COAST-Lab/Low-Cost-Multiparameter-Water-Quality-Sensor/Data Analysis Scripts/README.md

# Data Analysis Scripts

This folder contains data analysis scripts for the low-cost multiparameter sensor. 
The .csv file obtained from the low-cost multiparameter sensor code should be used for these scripts
NOT the .csv files obtained from the code for measurements of chlorophyll a and turbidity separately from one another. 

The 'turbidity' folder contains the Python code to analyze the turbidity measurements. and the 'chlorophyll' folder the Python code to analyze the chlorophyll a measurement
