COAST-Lab/Low-Cost-Multiparameter-Water-Quality-Sensor/Turbidity/Data Analysis Scripts/README.md

# Chlorophyll Data Analysis Scripts

This folder contains data analysis scripts for the turbidity portion of the low-cost multiparameter sensor. 
The .csv file obtained from the turbidity code should be used for these scripts
NOT the .csv files obtained from the code for measurements of chlorophyll a and turbidiy measured together.
