COAST-Lab/Low-Cost-Multiparameter-Water-Quality-Sensor/Chlorophyll/Data Analysis Scripts/README.md

# Chlorophyll Data Analysis Scripts

This folder contains data analysis scripts for the chlorophyll a portion of the low-cost multiparameter sensor. 
The .csv file obtained from the chlorophyll a code should be used for these scripts
NOT the .csv files obtained from the code for measurements of chlorophyll a and turbidiy measured together.
