COAST-Lab/Low-Cost-Multiparameter-Water-Quality-Sensor/Chlorophyll/Data Analysis/AS7341 Dilution Tests/Through Hole Design with 2:1 Ratio/2_22_24_700ms_128x_through_hole_dilutions_alan_optics_2.csv

Date and Time | ASTEP | ATIME | GAIN | LED Status | LED Intensity | Test | Seconds | Milliseconds | Type | F1 (Basic) | F2 (Basic) | F3 (Basic) | F4 (Basic) | F5 (Basic) | F6 (Basic) | F7 (Basic) | F8 (Basic) | Clear (Basic) | NIR (Basic) | Type | F1 (Raw) | F2 (Raw) | F3 (Raw) | F4 (Raw) | F5 (Raw) | F6 (Raw) | F7 (Raw) | F8 (Raw) | Clear (Raw) | NIR (Raw)
2112/5/32 (Thursday) 30:46:22 | 999 | 255 | 8 | LED ON | 255 | 0.0 | 3 | 3352 | BASIC COUNTS | 0.00 | 0.00 | 0.00 | 0.00 | 0.00 | 0.00 | 0.00 | 0.00 | 0.00 | 0.00 | RAW VALUES | 0 | 0 | 0 | 0 | 0 | 0 | 0 | 0 | 0 | 0
2112/5/32 (Thursday) 30:46:25 | 999 | 255 | 8 | LED ON | 255 | 0.0 | 6 | 6380 | BASIC COUNTS | 0.00 | 0.01 | 0.00 | 0.00 | 0.00 | 0.00 | 0.00 | 0.00 | 0.01 | 0.00 | RAW VALUES | 434 | 701 | 63 | 31 | 22 | 26 | 30 | 21 | 670 | 0
2112/5/32 (Thursday) 30:46:28 | 999 | 255 | 8 | LED ON | 255 | 0.0 | 9 | 9403 | BASIC COUNTS | 0.00 | 0.01 | 0.00 | 0.00 | 0.00 | 0.00 | 0.00 | 0.00 | 0.01 | 0.00 | RAW VALUES | 432 | 702 | 63 | 31 | 22 | 26 | 31 | 21 | 671 | 0
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
