COAST-Lab/Low-Cost-Multiparameter-Water-Quality-Sensor/Chlorophyll/Data Analysis/AS7341 Dilution Tests/Through Hole Design with 2:1 Ratio/LED with marine grade epoxy/2_29_24_graph_128x_700ms_LOD.png

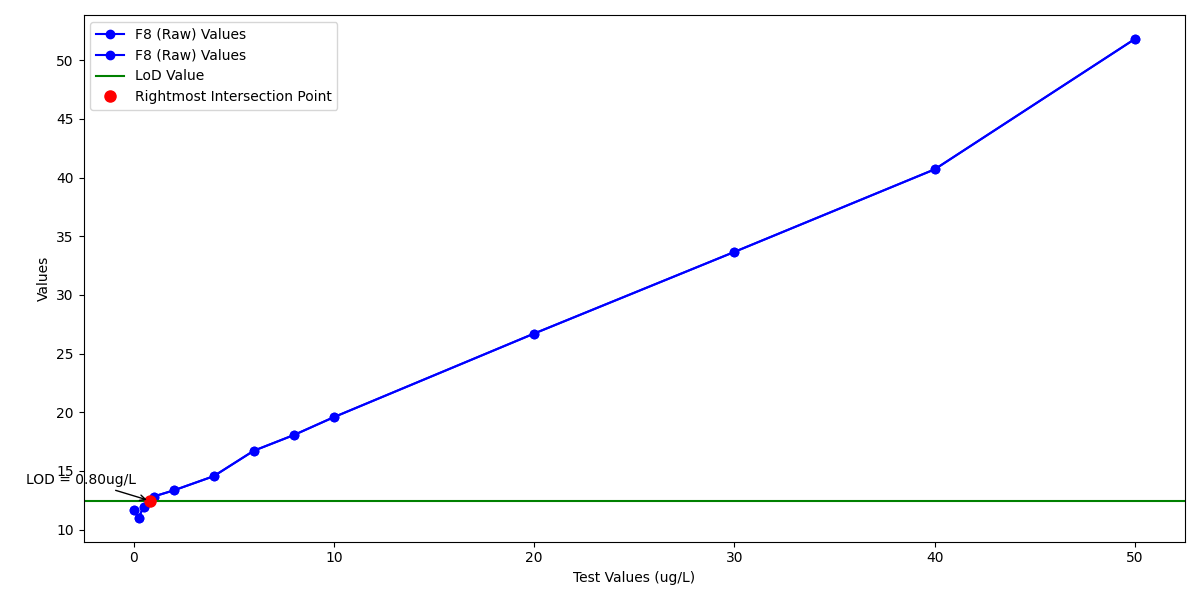
Chlorophyll/Data Analysis/AS7341 Dilution Tests/Through Hole Design with 2:1 Ratio/LED with marine grade epoxy/2_29_24_graph_128x_700ms_LOD.png
