COAST-Lab/Low-Cost-Multiparameter-Water-Quality-Sensor/Chlorophyll/Data Analysis/AS7341 Dilution Tests/Through Hole Design with 2:1 Ratio/LED with marine grade epoxy/2_29_24_LoD_128x_700ms.png

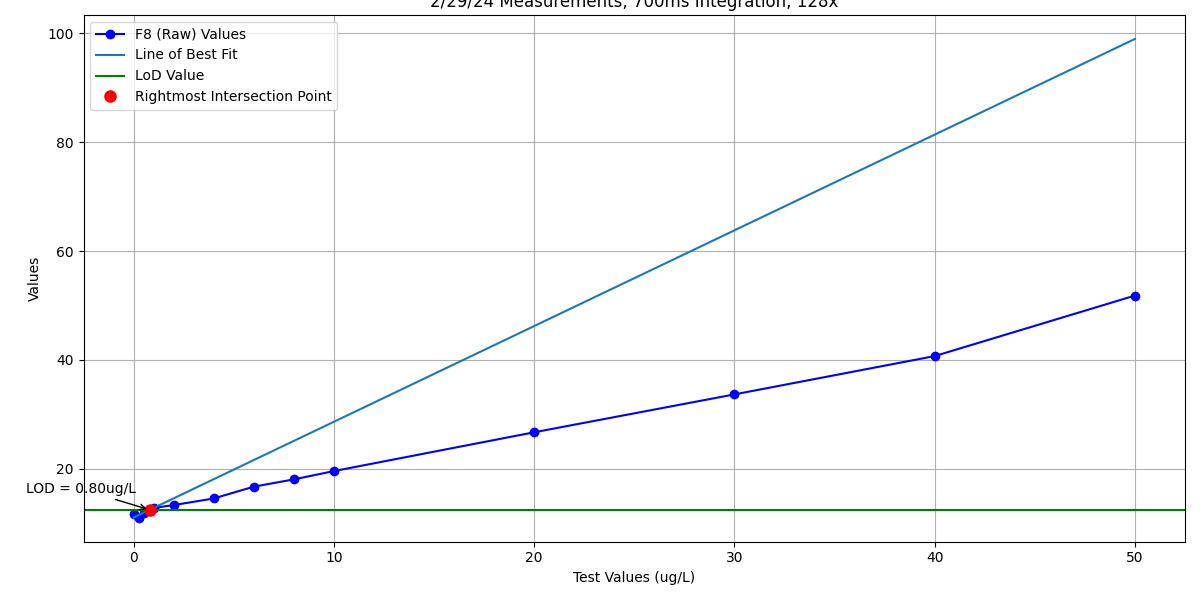
Chlorophyll/Data Analysis/AS7341 Dilution Tests/Through Hole Design with 2:1 Ratio/LED with marine grade epoxy/2_29_24_LoD_128x_700ms.png
