COAST-Lab/Low-Cost-Multiparameter-Water-Quality-Sensor/Hardware/Circuit Diagram/low_cost_sesnor.png

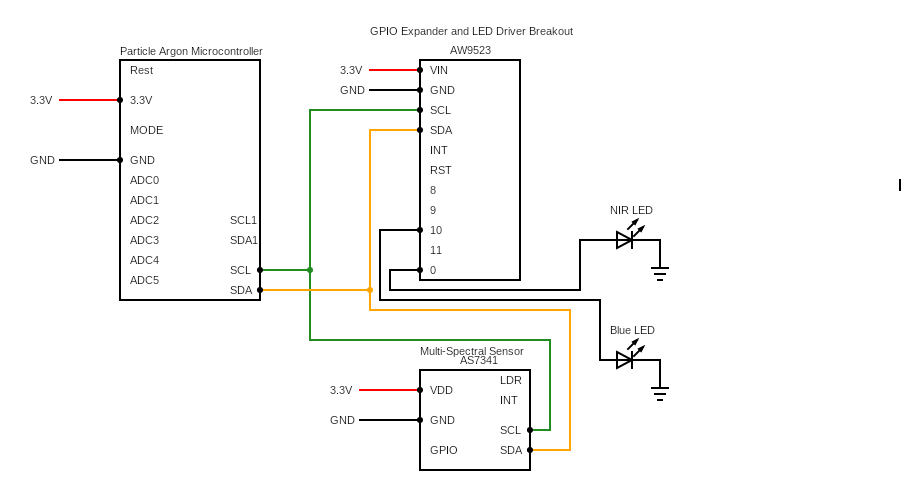
Hardware/Circuit Diagram/low_cost_sesnor.png
