COAST-Lab/Low-Cost-Multiparameter-Water-Quality-Sensor/Hardware/Water Resistant Housing/light_blocking_cap_2.stl

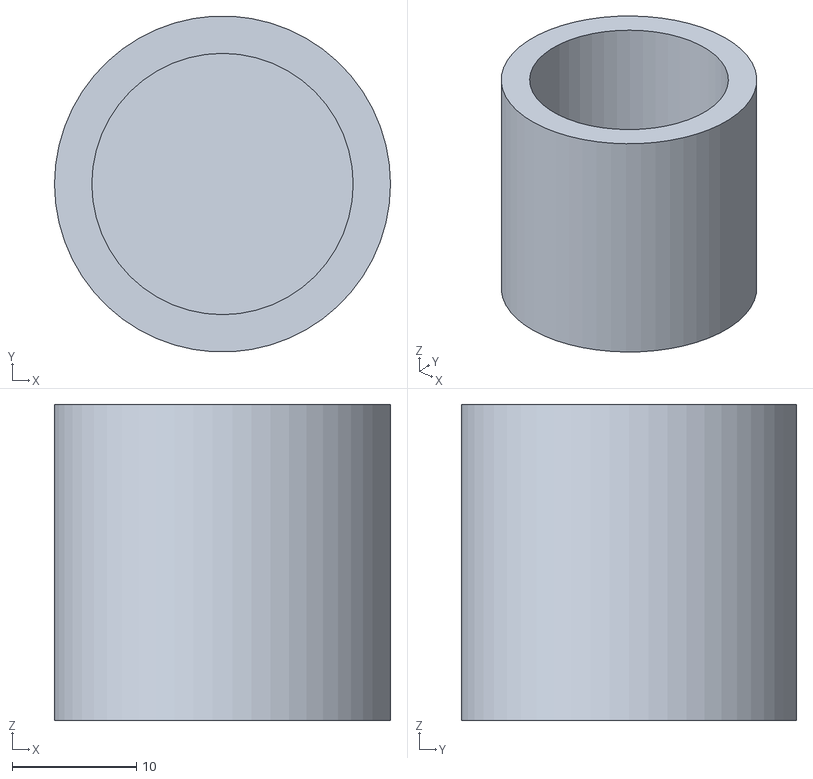
[picture p9: CAD file, 2024-05-28]
Hardware/Water Resistant Housing/light_blocking_cap_2.stl
27.0 x 27.0 x 25.4
