COAST-Lab/Low-Cost-Multiparameter-Water-Quality-Sensor/Hardware/Water Resistant Housing/3d_enclosure_2_19_top_1.stl

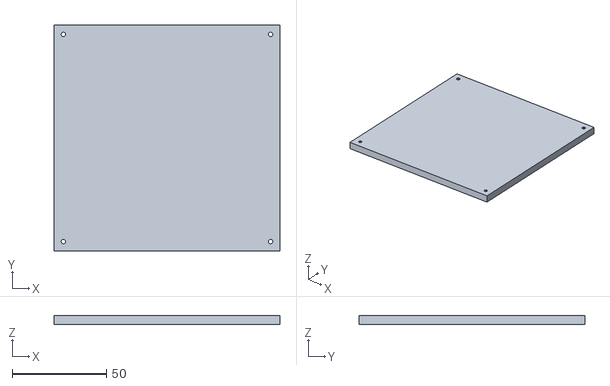
[picture p10: CAD file, 2024-05-28]
Hardware/Water Resistant Housing/3d_enclosure_2_19_top_1.stl
120.0 x 120.0 x 5.00
