COAST-Lab/Low-Cost-Multiparameter-Water-Quality-Sensor/Hardware/Water Resistant Housing/3d_enclosure_2_19_1_9_cm.stl

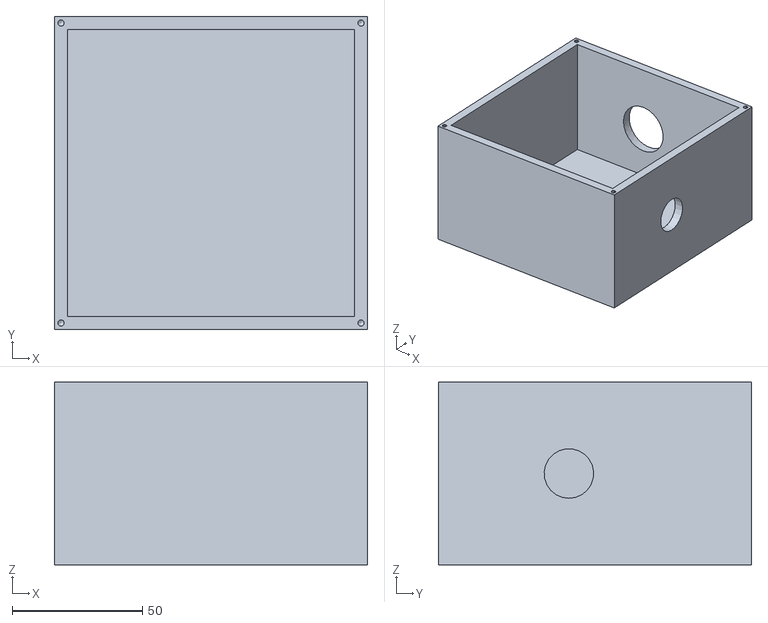
[picture p11: CAD file, 2024-05-28]
Hardware/Water Resistant Housing/3d_enclosure_2_19_1_9_cm.stl
120.0 x 120.0 x 70.0
