COAST-Lab/Low-Cost-Multiparameter-Water-Quality-Sensor/Hardware/Cuvette Holder/alan_optics_through_hole_chl_turbidity_screw_holes.stl

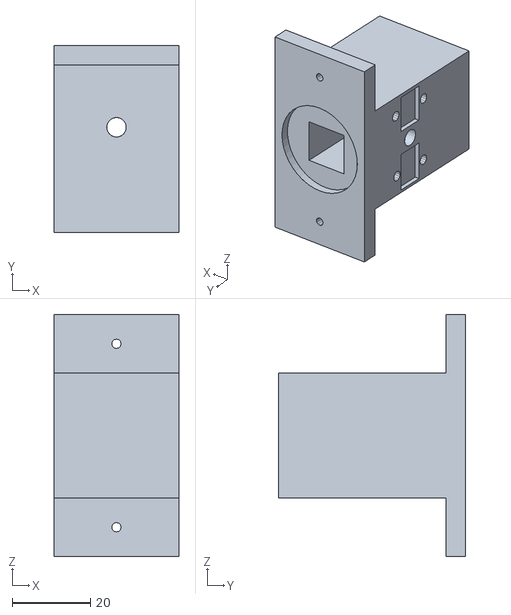
[picture p12: CAD file, 2024-05-31]
Hardware/Cuvette Holder/alan_optics_through_hole_chl_turbidity_screw_holes.stl
32.0 x 48.0 x 62.0
