COAST-Lab/Low-Cost-Multiparameter-Water-Quality-Sensor/(list of files, cad)

Other CAD files:
Hardware/Cuvette Holder/alan_optics_through_hole_chl_turbidity_screw_holes.ipt
Hardware/Water Resistant Housing/3d_enclosure_2_19_1_9_cm.ipt
Hardware/Water Resistant Housing/3d_enclosure_2_19_top_1.ipt
Hardware/Water Resistant Housing/light_blocking_cap_2.ipt
