COAST-Lab/Low-Cost-Multiparameter-Water-Quality-Sensor/Field Tests/4.15.24 Field Test/chl_dock_test_4_15_24_no_DI.csv

Date and Time | ASTEP | ATIME | GAIN | LED Status | LED Intensity | Test | Seconds | Milliseconds | Type | F1 (Basic) | F2 (Basic) | F3 (Basic) | F4 (Basic) | F5 (Basic) | F6 (Basic) | F7 (Basic) | F8 (Basic) | Clear (Basic) | NIR (Basic) | Type | F1 (Raw) | F2 (Raw) | F3 (Raw) | F4 (Raw) | F5 (Raw) | F6 (Raw) | F7 (Raw) | F8 (Raw) | Clear (Raw) | NIR (Raw) | Approx Time
2032/5/32 (Tuesday) 30:49:58 | 999 | 255 | 8 | LED ON | 255 | 2 | 3 | 3341 | BASIC COUNTS | 0.00 | 0.00 | 0.00 | 0.00 | 0.00 | 0.00 | 0.00 | 0.00 | 0.00 | 0.00 | RAW VALUES | 0 | 1 | 2 | 4 | 5 | 7 | 11 | 14 | 54 | 19 | 10:30
2032/5/32 (Tuesday) 30:50:1 | 999 | 255 | 8 | LED ON | 255 | 2 | 6 | 6371 | BASIC COUNTS | 0.01 | 0.01 | 0.00 | 0.00 | 0.00 | 0.00 | 0.00 | 0.00 | 0.02 | 0.00 | RAW VALUES | 659 | 928 | 89 | 63 | 47 | 60 | 65 | 55 | 1376 | 24 | 10:30
2032/5/32 (Tuesday) 30:50:4 | 999 | 255 | 8 | LED ON | 255 | 2 | 9 | 9399 | BASIC COUNTS | 0.01 | 0.01 | 0.00 | 0.00 | 0.00 | 0.00 | 0.00 | 0.00 | 0.02 | 0.00 | RAW VALUES | 659 | 935 | 89 | 63 | 47 | 60 | 64 | 53 | 1381 | 24 | 10:30
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
