COAST-Lab/Low-Cost-Multiparameter-Water-Quality-Sensor/Field Tests/4.15.24 Field Test/turb_dock_test_4_15_24_no_DI.csv

Date and Time | ASTEP | ATIME | GAIN | LED Status | LED Intensity | Test | Seconds | Milliseconds | Type | F1 (Basic) | F2 (Basic) | F3 (Basic) | F4 (Basic) | F5 (Basic) | F6 (Basic) | F7 (Basic) | F8 (Basic) | Clear (Basic) | NIR (Basic) | Type | F1 (Raw) | F2 (Raw) | F3 (Raw) | F4 (Raw) | F5 (Raw) | F6 (Raw) | F7 (Raw) | F8 (Raw) | Clear (Raw) | NIR (Raw) | Approx Time
2113/7/38 (Tuesday) 38:8:4 | 999 | 255 | 8 | LED ON | 255 | 1 | 3 | 3356 | BASIC COUNTS | 0.00 | 0.00 | 0.00 | 0.00 | 0.00 | 0.00 | 0.00 | 0.00 | 0.00 | 0.00 | RAW VALUES | 7 | 19 | 26 | 35 | 39 | 47 | 61 | 70 | 238 | 92 | 10:15
2113/7/38 (Tuesday) 38:8:7 | 999 | 255 | 8 | LED ON | 255 | 1 | 6 | 6385 | BASIC COUNTS | 0.00 | 0.00 | 0.00 | 0.00 | 0.00 | 0.00 | 0.00 | 0.00 | 0.01 | 0.03 | RAW VALUES | 16 | 22 | 23 | 24 | 17 | 31 | 15 | 15 | 757 | 2778 | 10:15
2113/7/38 (Tuesday) 38:8:10 | 999 | 255 | 8 | LED ON | 255 | 1 | 9 | 9415 | BASIC COUNTS | 0.00 | 0.00 | 0.00 | 0.00 | 0.00 | 0.00 | 0.00 | 0.00 | 0.01 | 0.03 | RAW VALUES | 15 | 21 | 20 | 22 | 17 | 31 | 15 | 14 | 757 | 2776 | 10:15
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
