COAST-Lab/Low-Cost-Multiparameter-Water-Quality-Sensor/Chlorophyll/Data Analysis/Dilution Tests with Water Resistant Housing/housing_chl_4_16_24.csv

Date and Time | ASTEP | ATIME | GAIN | LED Status | LED Intensity | Test | Seconds | Milliseconds | Type | F1 (Basic) | F2 (Basic) | F3 (Basic) | F4 (Basic) | F5 (Basic) | F6 (Basic) | F7 (Basic) | F8 (Basic) | Clear (Basic) | NIR (Basic) | Type | F1 (Raw) | F2 (Raw) | F3 (Raw) | F4 (Raw) | F5 (Raw) | F6 (Raw) | F7 (Raw) | F8 (Raw) | Clear (Raw) | NIR (Raw) | Approx Time
2112/5/32 (Thursday) 30:47:20 | 999 | 255 | 8 | LED ON | 255 | 50 | 3 | 3344 | BASIC COUNTS | 0.00 | 0.00 | 0.00 | 0.00 | 0.00 | 0.00 | 0.00 | 0.00 | 0.00 | 0.00 | RAW VALUES | 0 | 0 | 0 | 0 | 0 | 0 | 0 | 0 | 0 | 0 | time
2112/5/32 (Thursday) 30:47:23 | 999 | 255 | 8 | LED ON | 255 | 50 | 6 | 6373 | BASIC COUNTS | 0.00 | 0.01 | 0.00 | 0.00 | 0.00 | 0.00 | 0.00 | 0.00 | 0.01 | 0.00 | RAW VALUES | 291 | 464 | 45 | 27 | 137 | 259 | 129 | 44 | 861 | 8 | time
2112/5/32 (Thursday) 30:47:26 | 999 | 255 | 8 | LED ON | 255 | 50 | 9 | 9404 | BASIC COUNTS | 0.00 | 0.01 | 0.00 | 0.00 | 0.00 | 0.00 | 0.00 | 0.00 | 0.01 | 0.00 | RAW VALUES | 290 | 464 | 45 | 27 | 138 | 259 | 128 | 44 | 860 | 7 | time
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
