COAST-Lab/Low-Cost-Multiparameter-Water-Quality-Sensor/Field Tests/4.23.24 Field Tests/Indoor Field Test/inside_test_chl_4_23_24_no_time.csv

Date and Time | ASTEP | ATIME | GAIN | LED Status | LED Intensity | Test | Seconds | Milliseconds | Type | F1 (Basic) | F2 (Basic) | F3 (Basic) | F4 (Basic) | F5 (Basic) | F6 (Basic) | F7 (Basic) | F8 (Basic) | Clear (Basic) | NIR (Basic) | Type | F1 (Raw) | F2 (Raw) | F3 (Raw) | F4 (Raw) | F5 (Raw) | F6 (Raw) | F7 (Raw) | F8 (Raw) | Clear (Raw) | NIR (Raw) | Approx Time
2032/5/32 (Tuesday) 30:47:29 | 999 | 255 | 8 | LED ON | 255 | 1 | 3 | 3368 | BASIC COUNTS | 0.00 | 0.00 | 0.00 | 0.00 | 0.00 | 0.00 | 0.00 | 0.00 | 0.00 | 0.00 | RAW VALUES | 0 | 0 | 0 | 0 | 0 | 0 | 0 | 0 | 0 | 0 | 11:30
2032/5/32 (Tuesday) 30:47:32 | 999 | 255 | 8 | LED ON | 255 | 1 | 6 | 6398 | BASIC COUNTS | 0.01 | 0.01 | 0.00 | 0.00 | 0.00 | 0.00 | 0.00 | 0.00 | 0.02 | 0.00 | RAW VALUES | 738 | 1088 | 86 | 47 | 31 | 46 | 49 | 35 | 1429 | 0 | 11:30
2032/5/32 (Tuesday) 30:47:35 | 999 | 255 | 8 | LED ON | 255 | 1 | 9 | 9426 | BASIC COUNTS | 0.01 | 0.01 | 0.00 | 0.00 | 0.00 | 0.00 | 0.00 | 0.00 | 0.02 | 0.00 | RAW VALUES | 734 | 1089 | 85 | 47 | 33 | 47 | 48 | 35 | 1440 | 0 | 11:30
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
