COAST-Lab/Low-Cost-Multiparameter-Water-Quality-Sensor/Field Tests/4.23.24 Field Tests/Indoor Field Test/inside_test_turb_4_23_24_no_time.csv

Date and Time | ASTEP | ATIME | GAIN | LED Status | LED Intensity | Test | Seconds | Milliseconds | Type | F1 (Basic) | F2 (Basic) | F3 (Basic) | F4 (Basic) | F5 (Basic) | F6 (Basic) | F7 (Basic) | F8 (Basic) | Clear (Basic) | NIR (Basic) | Type | F1 (Raw) | F2 (Raw) | F3 (Raw) | F4 (Raw) | F5 (Raw) | F6 (Raw) | F7 (Raw) | F8 (Raw) | Clear (Raw) | NIR (Raw) | Approx Time
2032/5/32 (Tuesday) 30:46:22 | 999 | 255 | 8 | LED ON | 255 | 1 | 3 | 3357 | BASIC COUNTS | 0.00 | 0.00 | 0.00 | 0.00 | 0.00 | 0.00 | 0.00 | 0.00 | 0.00 | 0.00 | RAW VALUES | 0 | 0 | 0 | 0 | 0 | 0 | 0 | 0 | 0 | 0 | 11:30
2032/5/32 (Tuesday) 30:46:25 | 999 | 255 | 8 | LED ON | 255 | 1 | 6 | 6392 | BASIC COUNTS | 0.00 | 0.00 | 0.00 | 0.00 | 0.00 | 0.00 | 0.00 | 0.00 | 0.01 | 0.03 | RAW VALUES | 11 | 16 | 14 | 17 | 12 | 25 | 10 | 11 | 660 | 2408 | 11:30
2032/5/32 (Tuesday) 30:46:28 | 999 | 255 | 8 | LED ON | 255 | 1 | 9 | 9422 | BASIC COUNTS | 0.00 | 0.00 | 0.00 | 0.00 | 0.00 | 0.00 | 0.00 | 0.00 | 0.01 | 0.03 | RAW VALUES | 11 | 16 | 15 | 16 | 12 | 25 | 11 | 11 | 642 | 2366 | 11:30
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
