COAST-Lab/Low-Cost-Multiparameter-Water-Quality-Sensor/Field Tests/4.23.24 Field Tests/Outdoor Field Test/dock_test_turb_4_23_24_no_DI.csv

Date and Time | ASTEP | ATIME | GAIN | LED Status | LED Intensity | Test | Seconds | Milliseconds | Type | F1 (Basic) | F2 (Basic) | F3 (Basic) | F4 (Basic) | F5 (Basic) | F6 (Basic) | F7 (Basic) | F8 (Basic) | Clear (Basic) | NIR (Basic) | Type | F1 (Raw) | F2 (Raw) | F3 (Raw) | F4 (Raw) | F5 (Raw) | F6 (Raw) | F7 (Raw) | F8 (Raw) | Clear (Raw) | NIR (Raw) | Approx Time
2112/5/32 (Thursday) 30:7:42 | 999 | 255 | 8 | LED ON | 255 | 1 | 3 | 3357 | BASIC COUNTS | 0.00 | 0.00 | 0.00 | 0.00 | 0.00 | 0.00 | 0.00 | 0.00 | 0.00 | 0.00 | RAW VALUES | 0 | 0 | 0 | 0 | 0 | 0 | 0 | 0 | 0 | 0 | 8:45
2112/5/32 (Thursday) 30:7:45 | 999 | 255 | 8 | LED ON | 255 | 1 | 6 | 6389 | BASIC COUNTS | 0.00 | 0.00 | 0.00 | 0.00 | 0.00 | 0.00 | 0.00 | 0.00 | 0.01 | 0.03 | RAW VALUES | 13 | 18 | 16 | 19 | 14 | 28 | 13 | 11 | 732 | 2450 | 8:45
2112/5/32 (Thursday) 30:7:48 | 999 | 255 | 8 | LED ON | 255 | 1 | 9 | 9417 | BASIC COUNTS | 0.00 | 0.00 | 0.00 | 0.00 | 0.00 | 0.00 | 0.00 | 0.00 | 0.01 | 0.03 | RAW VALUES | 13 | 17 | 16 | 19 | 13 | 28 | 13 | 11 | 730 | 2448 | 8:45
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
