COAST-Lab/Low-Cost-Multiparameter-Water-Quality-Sensor/Turbidity/Data Analysis/Dilution Tests with Water Resistant Housing/housing_turb_dilutions_4_16_24.csv

Date and Time | ASTEP | ATIME | GAIN | LED Status | LED Intensity | Test | Seconds | Milliseconds | Type | F1 (Basic) | F2 (Basic) | F3 (Basic) | F4 (Basic) | F5 (Basic) | F6 (Basic) | F7 (Basic) | F8 (Basic) | Clear (Basic) | NIR (Basic) | Type | F1 (Raw) | F2 (Raw) | F3 (Raw) | F4 (Raw) | F5 (Raw) | F6 (Raw) | F7 (Raw) | F8 (Raw) | Clear (Raw) | NIR (Raw) | Approx Time
2012/5/32 (Friday) 30:46:23 | 999 | 255 | 8 | LED ON | 255 | 700 | 3 | 3343 | BASIC COUNTS | 0.00 | 0.00 | 0.00 | 0.00 | 0.00 | 0.00 | 0.00 | 0.00 | 0.00 | 0.00 | RAW VALUES | 0 | 0 | 0 | 0 | 0 | 0 | 0 | 0 | 0 | 0 | time
2012/5/32 (Friday) 30:46:26 | 999 | 255 | 8 | LED ON | 255 | 700 | 6 | 6374 | BASIC COUNTS | 0.00 | 0.01 | 0.01 | 0.01 | 0.00 | 0.01 | 0.00 | 0.00 | 0.18 | 0.61 | RAW VALUES | 379 | 489 | 484 | 511 | 415 | 680 | 359 | 341 | 16765 | 55778 | time
2012/5/32 (Friday) 30:46:29 | 999 | 255 | 8 | LED ON | 255 | 700 | 9 | 9409 | BASIC COUNTS | 0.00 | 0.01 | 0.01 | 0.01 | 0.00 | 0.01 | 0.00 | 0.00 | 0.18 | 0.61 | RAW VALUES | 377 | 488 | 481 | 510 | 413 | 679 | 360 | 340 | 16729 | 55796 | time
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
