COAST-Lab/Low-Cost-Multiparameter-Water-Quality-Sensor/Turbidity/Data Analysis/AS7341 Dilution Tests/4_9_24_700ms_128x_1_turbidity.csv

Date and Time | ASTEP | ATIME | GAIN | LED Status | LED Intensity | Test | Seconds | Milliseconds | Type | F1 (Basic) | F2 (Basic) | F3 (Basic) | F4 (Basic) | F5 (Basic) | F6 (Basic) | F7 (Basic) | F8 (Basic) | Clear (Basic) | NIR (Basic) | Type | F1 (Raw) | F2 (Raw) | F3 (Raw) | F4 (Raw) | F5 (Raw) | F6 (Raw) | F7 (Raw) | F8 (Raw) | Clear (Raw) | NIR (Raw)
2153/15/28 (Tuesday) 45:27:46 | 999 | 255 | 8 | LED ON | 255 | 700 | 3 | 3358 | BASIC COUNTS | 0.00 | 0.00 | 0.00 | 0.00 | 0.00 | 0.00 | 0.00 | 0.00 | 0.00 | 0.00 | RAW VALUES | 0 | 0 | 0 | 0 | 0 | 0 | 0 | 0 | 0 | 0
2153/15/28 (Tuesday) 45:27:49 | 999 | 255 | 8 | LED ON | 255 | 700 | 6 | 6393 | BASIC COUNTS | 0.00 | 0.01 | 0.00 | 0.01 | 0.00 | 0.01 | 0.00 | 0.00 | 0.17 | 0.58 | RAW VALUES | 354 | 461 | 454 | 482 | 388 | 641 | 337 | 321 | 15852 | 53179
2153/15/28 (Tuesday) 45:27:52 | 999 | 255 | 8 | LED ON | 255 | 700 | 9 | 9423 | BASIC COUNTS | 0.00 | 0.01 | 0.00 | 0.01 | 0.00 | 0.01 | 0.00 | 0.00 | 0.17 | 0.58 | RAW VALUES | 352 | 459 | 453 | 480 | 387 | 640 | 338 | 321 | 15810 | 53141
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
