COAST-Lab/Low-Cost-Multiparameter-Water-Quality-Sensor/Chlorophyll/Data Analysis/AS7341 Single Concentration Test/CoV Comparrison/AS7341_CoV_comparison.csv

 | Fall 2023 CoV | Spring 2024 CoV
No movement | 0.0098 | 0.0187
Movement | 0.0332 | 0.0226
Rinse | 0.0218 | 0.0454
