COAST-Lab/Low-Cost-Multiparameter-Water-Quality-Sensor/Chlorophyll/Data Analysis/AS7341 Single Concentration Test/2_8_24 Tests/2_8_24_700ms_256x_through_hole_no_movement.csv

Date and Time | ASTEP | ATIME | GAIN | LED Status | LED Intensity | Test | Seconds | Milliseconds | Type | F1 (Basic) | F2 (Basic) | F3 (Basic) | F4 (Basic) | F5 (Basic) | F6 (Basic) | F7 (Basic) | F8 (Basic) | Clear (Basic) | NIR (Basic) | Type | F1 (Raw) | F2 (Raw) | F3 (Raw) | F4 (Raw) | F5 (Raw) | F6 (Raw) | F7 (Raw) | F8 (Raw) | Clear (Raw) | NIR (Raw)
2104/5/32 (Monday) 30:7:37 | 999 | 255 | 9 | LED ON | 255 | 1 | 3 | 3317 | BASIC COUNTS | 0.00 | 0.00 | 0.00 | 0.00 | 0.00 | 0.00 | 0.00 | 0.00 | 0.00 | 0.00 | RAW VALUES | 0 | 0 | 0 | 0 | 4 | 0 | 0 | 0 | 6 | 0
2104/5/32 (Monday) 30:7:40 | 999 | 255 | 9 | LED ON | 255 | 1 | 6 | 6341 | BASIC COUNTS | 0.00 | 0.00 | 0.00 | 0.00 | 0.00 | 0.00 | 0.00 | 0.00 | 0.00 | 0.00 | RAW VALUES | 447 | 590 | 51 | 34 | 82 | 110 | 67 | 29 | 757 | 0
2104/5/32 (Monday) 30:7:43 | 999 | 255 | 9 | LED ON | 255 | 1 | 9 | 9363 | BASIC COUNTS | 0.00 | 0.00 | 0.00 | 0.00 | 0.00 | 0.00 | 0.00 | 0.00 | 0.00 | 0.00 | RAW VALUES | 446 | 591 | 50 | 34 | 82 | 108 | 66 | 29 | 757 | 0
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
