COAST-Lab/Low-Cost-Multiparameter-Water-Quality-Sensor/Chlorophyll/Data Analysis/AS7341 Single Concentration Test/2_8_24 Tests/2_8_24_700ms_256x_through_hole_rinse.csv

Date and Time | ASTEP | ATIME | GAIN | LED Status | LED Intensity | Test | Seconds | Milliseconds | Type | F1 (Basic) | F2 (Basic) | F3 (Basic) | F4 (Basic) | F5 (Basic) | F6 (Basic) | F7 (Basic) | F8 (Basic) | Clear (Basic) | NIR (Basic) | Type | F1 (Raw) | F2 (Raw) | F3 (Raw) | F4 (Raw) | F5 (Raw) | F6 (Raw) | F7 (Raw) | F8 (Raw) | Clear (Raw) | NIR (Raw)
2113/5/32 (Friday) 31:47:20 | 999 | 255 | 9 | LED ON | 255 | 1 | 3 | 3335 | BASIC COUNTS | 0.00 | 0.00 | 0.00 | 0.00 | 0.00 | 0.00 | 0.00 | 0.00 | 0.00 | 0.00 | RAW VALUES | 0 | 0 | 0 | 0 | 5 | 0 | 0 | 0 | 7 | 0
2113/5/32 (Friday) 31:47:23 | 999 | 255 | 9 | LED ON | 255 | 1 | 6 | 6353 | BASIC COUNTS | 0.00 | 0.00 | 0.00 | 0.00 | 0.00 | 0.00 | 0.00 | 0.00 | 0.00 | 0.00 | RAW VALUES | 451 | 605 | 50 | 33 | 79 | 107 | 67 | 29 | 770 | 0
2113/5/32 (Friday) 31:47:26 | 999 | 255 | 9 | LED ON | 255 | 1 | 9 | 9377 | BASIC COUNTS | 0.00 | 0.00 | 0.00 | 0.00 | 0.00 | 0.00 | 0.00 | 0.00 | 0.00 | 0.00 | RAW VALUES | 451 | 607 | 50 | 34 | 79 | 107 | 66 | 31 | 768 | 0
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
