COAST-Lab/Low-Cost-Multiparameter-Water-Quality-Sensor/Chlorophyll/Data Analysis/AS7341 Single Concentration Test/11.11.24 Tests/1_11_24_700ms_256x_movement_1.csv

Date and Time | ASTEP | ATIME | GAIN | LED Status | LED Intensity | Test | Milliseconds | Seconds | Type | F1 (Basic) | F2 (Basic) | F3 (Basic) | F4 (Basic) | F5 (Basic) | F6 (Basic) | F7 (Basic) | F8 (Basic) | Clear (Basic) | NIR (Basic) | Type | F1 (Raw) | F2 (Raw) | F3 (Raw) | F4 (Raw) | F5 (Raw) | F6 (Raw) | F7 (Raw) | F8 (Raw) | Clear (Raw) | NIR (Raw)
2024/1/8 (Monday) 15:36:24 | 999 | 255 | 9 | LED ON | 255 | 1 | 3 | 3318 | BASIC COUNTS | 0.00 | 0.00 | 0.00 | 0.00 | 0.00 | 0.00 | 0.00 | 0.00 | 0.00 | 0.00 | RAW VALUES | 0 | 0 | 0 | 70 | 90 | 17 | 0 | 0 | 136 | 0
2024/1/8 (Monday) 15:36:27 | 999 | 255 | 9 | LED ON | 255 | 1 | 6 | 6331 | BASIC COUNTS | 0.01 | 0.01 | 0.00 | 0.00 | 0.00 | 0.00 | 0.00 | 0.00 | 0.01 | 0.00 | RAW VALUES | 1091 | 1711 | 198 | 174 | 178 | 136 | 119 | 72 | 2030 | 8
2024/1/8 (Monday) 15:36:30 | 999 | 255 | 9 | LED ON | 255 | 1 | 9 | 9350 | BASIC COUNTS | 0.01 | 0.01 | 0.00 | 0.00 | 0.00 | 0.00 | 0.00 | 0.00 | 0.01 | 0.00 | RAW VALUES | 1088 | 1712 | 198 | 173 | 179 | 136 | 119 | 72 | 2029 | 6
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
