COAST-Lab/Low-Cost-Multiparameter-Water-Quality-Sensor/Chlorophyll/Data Analysis/AS7341 Single Concentration Test/11.11.24 Tests/1_11_24_700ms_256x_no_movement_1.csv

Date and Time | ASTEP | ATIME | GAIN | LED Status | LED Intensity | Test | Milliseconds | Seconds | Type | F1 (Basic) | F2 (Basic) | F3 (Basic) | F4 (Basic) | F5 (Basic) | F6 (Basic) | F7 (Basic) | F8 (Basic) | Clear (Basic) | NIR (Basic) | Type | F1 (Raw) | F2 (Raw) | F3 (Raw) | F4 (Raw) | F5 (Raw) | F6 (Raw) | F7 (Raw) | F8 (Raw) | Clear (Raw) | NIR (Raw)
2024/1/8 (Monday) 16:28:34 | 999 | 255 | 9 | LED ON | 255 | 1 | 3 | 3315 | BASIC COUNTS | 0.00 | 0.00 | 0.00 | 0.00 | 0.00 | 0.00 | 0.00 | 0.00 | 0.00 | 0.00 | RAW VALUES | 0 | 0 | 0 | 72 | 90 | 16 | 0 | 0 | 136 | 0
2024/1/8 (Monday) 16:28:37 | 999 | 255 | 9 | LED ON | 255 | 1 | 6 | 6339 | BASIC COUNTS | 0.01 | 0.01 | 0.00 | 0.00 | 0.00 | 0.00 | 0.00 | 0.00 | 0.01 | 0.00 | RAW VALUES | 1063 | 1631 | 188 | 171 | 181 | 141 | 118 | 70 | 1985 | 8
2024/1/8 (Monday) 16:28:40 | 999 | 255 | 9 | LED ON | 255 | 1 | 9 | 9357 | BASIC COUNTS | 0.01 | 0.01 | 0.00 | 0.00 | 0.00 | 0.00 | 0.00 | 0.00 | 0.01 | 0.00 | RAW VALUES | 1060 | 1635 | 189 | 171 | 178 | 140 | 118 | 72 | 1984 | 6
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
