COAST-Lab/Low-Cost-Multiparameter-Water-Quality-Sensor/Chlorophyll/Data Analysis/AS7341 Dilution Tests/AS7341 Dilutions 12.15.23/12_15_23_700ms_256x.csv

Date and Time | ASTEP | ATIME | GAIN | LED Status | LED Intensity | Test | Milliseconds | Seconds | Type | F1 (Basic) | F2 (Basic) | F3 (Basic) | F4 (Basic) | F5 (Basic) | F6 (Basic) | F7 (Basic) | F8 (Basic) | Clear (Basic) | NIR (Basic) | Type | F1 (Raw) | F2 (Raw) | F3 (Raw) | F4 (Raw) | F5 (Raw) | F6 (Raw) | F7 (Raw) | F8 (Raw) | Clear (Raw) | NIR (Raw)
2023/12/12 (Tuesday) 15:53:25 | 999 | 255 | 9 | LED ON | 255 | 0.25 | 3 | 3414 | BASIC COUNTS | 0.00 | 0.00 | 0.00 | 0.00 | 0.00 | 0.00 | 0.00 | 0.00 | 0.00 | 0.00 | RAW VALUES | 0 | 0 | 1 | 208 | 223 | 37 | 5 | 1 | 308 | 0
2023/12/12 (Tuesday) 15:53:28 | 999 | 255 | 9 | LED ON | 255 | 0.25 | 6 | 6536 | BASIC COUNTS | 0.00 | 0.00 | 0.00 | 0.00 | 0.00 | 0.00 | 0.00 | 0.00 | 0.00 | 0.00 | RAW VALUES | 160 | 155 | 18 | 219 | 230 | 47 | 17 | 8 | 585 | 0
2023/12/12 (Tuesday) 15:53:31 | 999 | 255 | 9 | LED ON | 255 | 0.25 | 9 | 9655 | BASIC COUNTS | 0.00 | 0.00 | 0.00 | 0.00 | 0.00 | 0.00 | 0.00 | 0.00 | 0.00 | 0.00 | RAW VALUES | 160 | 155 | 17 | 220 | 231 | 47 | 17 | 8 | 584 | 0
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
