COAST-Lab/Low-Cost-Multiparameter-Water-Quality-Sensor/Chlorophyll/Data Analysis/AS7341 Dilution Tests/AS7341 Dilutions 12.15.23/12_15_23_700ms_512x.csv

Date and Time | ASTEP | ATIME | GAIN | LED Status | LED Intensity | Test | Milliseconds | Seconds | Type | F1 (Basic) | F2 (Basic) | F3 (Basic) | F4 (Basic) | F5 (Basic) | F6 (Basic) | F7 (Basic) | F8 (Basic) | Clear (Basic) | NIR (Basic) | Type | F1 (Raw) | F2 (Raw) | F3 (Raw) | F4 (Raw) | F5 (Raw) | F6 (Raw) | F7 (Raw) | F8 (Raw) | Clear (Raw) | NIR (Raw)
2023/12/12 (Tuesday) 14:6:51 | 999 | 255 | 10 | LED ON | 255 | 50.0 | 3 | 3419 | BASIC COUNTS | 0.00 | 0.00 | 0.00 | 0.00 | 0.00 | 0.00 | 0.00 | 0.00 | 0.00 | 0.00 | RAW VALUES | 0 | 0 | 0 | 235 | 285 | 46 | 3 | 0 | 386 | 0
2023/12/12 (Tuesday) 14:6:54 | 999 | 255 | 10 | LED ON | 255 | 50.0 | 6 | 6540 | BASIC COUNTS | 0.00 | 0.00 | 0.00 | 0.00 | 0.00 | 0.00 | 0.00 | 0.00 | 0.00 | 0.00 | RAW VALUES | 823 | 767 | 78 | 291 | 356 | 143 | 91 | 39 | 1799 | 0
2023/12/12 (Tuesday) 14:6:57 | 999 | 255 | 10 | LED ON | 255 | 50.0 | 9 | 9665 | BASIC COUNTS | 0.00 | 0.00 | 0.00 | 0.00 | 0.00 | 0.00 | 0.00 | 0.00 | 0.00 | 0.00 | RAW VALUES | 812 | 767 | 76 | 291 | 354 | 145 | 90 | 40 | 1793 | 0
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
