COAST-Lab/Low-Cost-Multiparameter-Water-Quality-Sensor/Chlorophyll/Data Analysis/AS7341 Dilution Tests/AS7341 Dilutions 1.5.24/1_5_24_700ms_256x.csv

Date and Time | ASTEP | ATIME | GAIN | LED Status | LED Intensity | Test | Milliseconds | Seconds | Type | F1 (Basic) | F2 (Basic) | F3 (Basic) | F4 (Basic) | F5 (Basic) | F6 (Basic) | F7 (Basic) | F8 (Basic) | Clear (Basic) | NIR (Basic) | Type | F1 (Raw) | F2 (Raw) | F3 (Raw) | F4 (Raw) | F5 (Raw) | F6 (Raw) | F7 (Raw) | F8 (Raw) | Clear (Raw) | NIR (Raw)
2024/1/2 (Tuesday) 17:9:23 | 999 | 255 | 9 | LED ON | 255 | 50.0 | 3 | 3324 | BASIC COUNTS | 0.00 | 0.00 | 0.00 | 0.00 | 0.00 | 0.00 | 0.00 | 0.00 | 0.00 | 0.00 | RAW VALUES | 0 | 0 | 0 | 29 | 42 | 6 | 0 | 0 | 60 | 0
2024/1/2 (Tuesday) 17:9:26 | 999 | 255 | 9 | LED ON | 255 | 50.0 | 6 | 6346 | BASIC COUNTS | 0.01 | 0.01 | 0.00 | 0.00 | 0.00 | 0.00 | 0.00 | 0.00 | 0.01 | 0.00 | RAW VALUES | 1119 | 1821 | 245 | 160 | 196 | 223 | 150 | 92 | 2198 | 8
2024/1/2 (Tuesday) 17:9:29 | 999 | 255 | 9 | LED ON | 255 | 50.0 | 9 | 9363 | BASIC COUNTS | 0.01 | 0.01 | 0.00 | 0.00 | 0.00 | 0.00 | 0.00 | 0.00 | 0.01 | 0.00 | RAW VALUES | 1114 | 1828 | 245 | 159 | 195 | 221 | 150 | 93 | 2199 | 8
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
