COAST-Lab/Low-Cost-Multiparameter-Water-Quality-Sensor/Chlorophyll/Data Analysis/AS7341 Dilution Tests/AS7341 Dilutions 1.5.24/1_5_24_700ms_512x.csv

Date and Time | ASTEP | ATIME | GAIN | LED Status | LED Intensity | Test | Milliseconds | Seconds | Type | F1 (Basic) | F2 (Basic) | F3 (Basic) | F4 (Basic) | F5 (Basic) | F6 (Basic) | F7 (Basic) | F8 (Basic) | Clear (Basic) | NIR (Basic) | Type | F1 (Raw) | F2 (Raw) | F3 (Raw) | F4 (Raw) | F5 (Raw) | F6 (Raw) | F7 (Raw) | F8 (Raw) | Clear (Raw) | NIR (Raw)
2024/1/2 (Tuesday) 17:45:45 | 999 | 255 | 10 | LED ON | 255 | 50.0 | 3 | 3312 | BASIC COUNTS | 0.00 | 0.00 | 0.00 | 0.00 | 0.00 | 0.00 | 0.00 | 0.00 | 0.00 | 0.00 | RAW VALUES | 0 | 0 | 0 | 55 | 83 | 12 | 0 | 0 | 121 | 0
2024/1/2 (Tuesday) 17:45:48 | 999 | 255 | 10 | LED ON | 255 | 50.0 | 6 | 6334 | BASIC COUNTS | 0.00 | 0.00 | 0.00 | 0.00 | 0.00 | 0.00 | 0.00 | 0.00 | 0.01 | 0.00 | RAW VALUES | 1069 | 1755 | 254 | 196 | 311 | 356 | 202 | 114 | 2289 | 3
2024/1/2 (Tuesday) 17:45:51 | 999 | 255 | 10 | LED ON | 255 | 50.0 | 9 | 9350 | BASIC COUNTS | 0.00 | 0.00 | 0.00 | 0.00 | 0.00 | 0.00 | 0.00 | 0.00 | 0.01 | 0.00 | RAW VALUES | 1067 | 1758 | 253 | 196 | 311 | 356 | 204 | 114 | 2287 | 3
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
