COAST-Lab/Low-Cost-Multiparameter-Water-Quality-Sensor/Chlorophyll/Data Analysis/AS7341 Dilution Tests/IO Rodeo Through Hole/2.20.24/2_20_24_700ms_128x_through_hole_dilutions_1.csv

Date and Time | ASTEP | ATIME | GAIN | LED Status | LED Intensity | Test | Seconds | Milliseconds | Type | F1 (Basic) | F2 (Basic) | F3 (Basic) | F4 (Basic) | F5 (Basic) | F6 (Basic) | F7 (Basic) | F8 (Basic) | Clear (Basic) | NIR (Basic) | Type | F1 (Raw) | F2 (Raw) | F3 (Raw) | F4 (Raw) | F5 (Raw) | F6 (Raw) | F7 (Raw) | F8 (Raw) | Clear (Raw) | NIR (Raw)
2113/1/26 (Friday) 30:47:52 | 999 | 255 | 8 | LED ON | 255 | 0.0 | 3 | 3323 | BASIC COUNTS | 0.00 | 0.00 | 0.00 | 0.00 | 0.00 | 0.00 | 0.00 | 0.00 | 0.00 | 0.00 | RAW VALUES | 0 | 0 | 0 | 0 | 2 | 0 | 0 | 0 | 3 | 0
2113/1/26 (Friday) 30:47:55 | 999 | 255 | 8 | LED ON | 255 | 0.0 | 6 | 6342 | BASIC COUNTS | 0.00 | 0.00 | 0.00 | 0.00 | 0.00 | 0.00 | 0.00 | 0.00 | 0.00 | 0.00 | RAW VALUES | 128 | 211 | 14 | 7 | 8 | 6 | 6 | 4 | 203 | 0
2113/1/26 (Friday) 30:47:58 | 999 | 255 | 8 | LED ON | 255 | 0.0 | 9 | 9363 | BASIC COUNTS | 0.00 | 0.00 | 0.00 | 0.00 | 0.00 | 0.00 | 0.00 | 0.00 | 0.00 | 0.00 | RAW VALUES | 128 | 211 | 14 | 8 | 8 | 6 | 6 | 3 | 203 | 0
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
