COAST-Lab/Low-Cost-Multiparameter-Water-Quality-Sensor/Chlorophyll/Data Analysis/AS7341 Dilution Tests/IO Rodeo Through Hole/2.20.24/2_20_24_700ms_256x_through_hole_dilutions.csv

Date and Time | ASTEP | ATIME | GAIN | LED Status | LED Intensity | Test | Seconds | Milliseconds | Type | F1 (Basic) | F2 (Basic) | F3 (Basic) | F4 (Basic) | F5 (Basic) | F6 (Basic) | F7 (Basic) | F8 (Basic) | Clear (Basic) | NIR (Basic) | Type | F1 (Raw) | F2 (Raw) | F3 (Raw) | F4 (Raw) | F5 (Raw) | F6 (Raw) | F7 (Raw) | F8 (Raw) | Clear (Raw) | NIR (Raw)
2112/5/32 (Thursday) 30:46:21 | 999 | 255 | 9 | LED ON | 255 | 0.25 | 3 | 3322 | BASIC COUNTS | 0.00 | 0.00 | 0.00 | 0.00 | 0.00 | 0.00 | 0.00 | 0.00 | 0.00 | 0.00 | RAW VALUES | 0 | 0 | 0 | 0 | 4 | 0 | 0 | 0 | 5 | 0
2112/5/32 (Thursday) 30:46:24 | 999 | 255 | 9 | LED ON | 255 | 0.25 | 6 | 6345 | BASIC COUNTS | 0.00 | 0.00 | 0.00 | 0.00 | 0.00 | 0.00 | 0.00 | 0.00 | 0.00 | 0.00 | RAW VALUES | 447 | 609 | 52 | 30 | 26 | 24 | 28 | 16 | 706 | 0
2112/5/32 (Thursday) 30:46:27 | 999 | 255 | 9 | LED ON | 255 | 0.25 | 9 | 9366 | BASIC COUNTS | 0.00 | 0.00 | 0.00 | 0.00 | 0.00 | 0.00 | 0.00 | 0.00 | 0.00 | 0.00 | RAW VALUES | 451 | 616 | 53 | 32 | 26 | 25 | 27 | 17 | 712 | 0
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
