COAST-Lab/Low-Cost-Multiparameter-Water-Quality-Sensor/Chlorophyll/Data Analysis/AS7341 Dilution Tests/IO Rodeo Through Hole/2.12.24/2_12_24_700ms_128x_through_hole_dilutions.csv

Date and Time | ASTEP | ATIME | GAIN | LED Status | LED Intensity | Test | Seconds | Milliseconds | Type | F1 (Basic) | F2 (Basic) | F3 (Basic) | F4 (Basic) | F5 (Basic) | F6 (Basic) | F7 (Basic) | F8 (Basic) | Clear (Basic) | NIR (Basic) | Type | F1 (Raw) | F2 (Raw) | F3 (Raw) | F4 (Raw) | F5 (Raw) | F6 (Raw) | F7 (Raw) | F8 (Raw) | Clear (Raw) | NIR (Raw)
2032/5/32 (Tuesday) 30:46:34 | 999 | 255 | 8 | LED ON | 255 | 0.0 | 3 | 3324 | BASIC COUNTS | 0.00 | 0.00 | 0.00 | 0.00 | 0.00 | 0.00 | 0.00 | 0.00 | 0.00 | 0.00 | RAW VALUES | 0 | 0 | 0 | 0 | 2 | 0 | 0 | 0 | 3 | 0
2032/5/32 (Tuesday) 30:46:38 | 999 | 255 | 8 | LED ON | 255 | 0.0 | 6 | 6348 | BASIC COUNTS | 0.00 | 0.00 | 0.00 | 0.00 | 0.00 | 0.00 | 0.00 | 0.00 | 0.00 | 0.00 | RAW VALUES | 204 | 293 | 22 | 13 | 11 | 10 | 12 | 8 | 304 | 0
2032/5/32 (Tuesday) 30:46:41 | 999 | 255 | 8 | LED ON | 255 | 0.0 | 9 | 9369 | BASIC COUNTS | 0.00 | 0.00 | 0.00 | 0.00 | 0.00 | 0.00 | 0.00 | 0.00 | 0.00 | 0.00 | RAW VALUES | 203 | 294 | 22 | 13 | 11 | 10 | 12 | 7 | 304 | 0
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
