COAST-Lab/Low-Cost-Multiparameter-Water-Quality-Sensor/Chlorophyll/Data Analysis/AS7341 Dilution Tests/IO Rodeo Through Hole/2.12.24/2_12_24_700ms_512x_through_hole_dilutions.csv

Date and Time | ASTEP | ATIME | GAIN | LED Status | LED Intensity | Test | Seconds | Milliseconds | Type | F1 (Basic) | F2 (Basic) | F3 (Basic) | F4 (Basic) | F5 (Basic) | F6 (Basic) | F7 (Basic) | F8 (Basic) | Clear (Basic) | NIR (Basic) | Type | F1 (Raw) | F2 (Raw) | F3 (Raw) | F4 (Raw) | F5 (Raw) | F6 (Raw) | F7 (Raw) | F8 (Raw) | Clear (Raw) | NIR (Raw)
2112/5/32 (Thursday) 30:46:25 | 999 | 255 | 10 | LED ON | 255 | 0.0 | 3 | 3343 | BASIC COUNTS | 0.00 | 0.00 | 0.00 | 0.00 | 0.00 | 0.00 | 0.00 | 0.00 | 0.00 | 0.00 | RAW VALUES | 0 | 0 | 0 | 0 | 7 | 0 | 0 | 0 | 10 | 0
2112/5/32 (Thursday) 30:46:28 | 999 | 255 | 10 | LED ON | 255 | 0.0 | 6 | 6367 | BASIC COUNTS | 0.00 | 0.00 | 0.00 | 0.00 | 0.00 | 0.00 | 0.00 | 0.00 | 0.00 | 0.00 | RAW VALUES | 733 | 1029 | 78 | 47 | 42 | 36 | 40 | 26 | 1099 | 0
2112/5/32 (Thursday) 30:46:31 | 999 | 255 | 10 | LED ON | 255 | 0.0 | 9 | 9390 | BASIC COUNTS | 0.00 | 0.00 | 0.00 | 0.00 | 0.00 | 0.00 | 0.00 | 0.00 | 0.00 | 0.00 | RAW VALUES | 728 | 1031 | 79 | 47 | 42 | 35 | 40 | 25 | 1097 | 0
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
