COAST-Lab/Low-Cost-Multiparameter-Water-Quality-Sensor/Field Tests/In Lab Field Test/inside_test_chl_5_13_24.csv

Date and Time | ASTEP | ATIME | GAIN | LED Status | LED Intensity | Seconds | Milliseconds | Type | F1 (Basic) | F2 (Basic) | F3 (Basic) | F4 (Basic) | F5 (Basic) | F6 (Basic) | F7 (Basic) | F8 (Basic) | Clear (Basic) | NIR (Basic) | Type | F1 (Raw) | F2 (Raw) | F3 (Raw) | F4 (Raw) | F5 (Raw) | F6 (Raw) | F7 (Raw) | F8 (Raw) | Clear (Raw) | NIR (Raw) | Trial
2112/15/20 (Saturday) 39:55:23 | 999 | 255 | 8 | LED ON | 255 | 3 | 3381 | BASIC COUNTS | 0.00 | 0.00 | 0.00 | 0.00 | 0.00 | 0.00 | 0.00 | 0.00 | 0.00 | 0.00 | RAW VALUES | 0 | 0 | 0 | 0 | 0 | 0 | 0 | 0 | 0 | 0 | DI
2112/15/20 (Saturday) 39:55:26 | 999 | 255 | 8 | LED ON | 255 | 6 | 6417 | BASIC COUNTS | 0.00 | 0.00 | 0.00 | 0.00 | 0.00 | 0.00 | 0.00 | 0.00 | 0.00 | 0.00 | RAW VALUES | 214 | 329 | 26 | 12 | 6 | 11 | 12 | 5 | 430 | 0 | DI
2112/15/20 (Saturday) 39:55:29 | 999 | 255 | 8 | LED ON | 255 | 9 | 9449 | BASIC COUNTS | 0.00 | 0.00 | 0.00 | 0.00 | 0.00 | 0.00 | 0.00 | 0.00 | 0.00 | 0.00 | RAW VALUES | 214 | 330 | 26 | 13 | 6 | 10 | 11 | 5 | 430 | 0 | DI
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
