COAST-Lab/Low-Cost-Multiparameter-Water-Quality-Sensor/Field Tests/In Lab Field Test/5_13_alan.xlsx

Date | Trial | Measurement Type | Measurement Number | Measurement Value
5.13 | DI | Continuous | 1 | 3
5.13 | DI | Continuous | 2 | 10
5.13 | DI | Continuous | 3 | 13
5.13 | DI | Continuous | 4 | 7
5.13 | DI | Continuous | 5 | 8
5.13 | DI | Continuous | 6 | 8
5.13 | DI | Continuous | 7 | 9
5.13 | DI | Continuous | 8 | 11
5.13 | DI | Continuous | 9 | 16
5.13 | DI | Continuous | 10 | 6
5.13 | DI | Continuous | 11 | 7
5.13 | DI | Continuous | 12 | 9
5.13 | DI | Continuous | 13 | 11
5.13 | DI | Continuous | 14 | 10
5.13 | DI | Continuous | 15 | 0
5.13 | DI | Continuous | 16 | 8
5.13 | DI | Continuous | 17 | 6
5.13 | DI | Continuous | 18 | 10
5.13 | DI | Continuous | 19 | 15
5.13 | DI | Continuous | 20 | 10
5.13 | DI | Continuous | 21 | 11
5.13 | DI | Continuous | 22 | 6
5.13 | DI | Continuous | 23 | 10
5.13 | DI | Continuous | 24 | 12
5.13 | DI | Continuous | 25 | 10
5.13 | DI | Continuous | 26 | 7
5.13 | DI | Continuous | 27 | 11
5.13 | DI | Continuous | 28 | 3
5.13 | DI | Continuous | 29 | 7
5.13 | DI | Continuous | 30 | 6
5.13 | DI | Continuous | 31 | 0
5.13 | DI | Continuous | 32 | 12
5.13 | DI | Continuous | 33 | 12
5.13 | DI | Continuous | 34 | 1
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
