COAST-Lab/Low-Cost-Multiparameter-Water-Quality-Sensor/Field Tests/In Lab Field Test/KorEXO Measurement File Export - 051324 103014_YSI.xlsx

Date (MM/DD/YYYY) | Time (HH:mm:ss) | Trial | Time (Fract. Sec) | Site Name | Chlorophyll RFU | Cond µS/cm | Depth m | fDOM QSU | fDOM RFU | nLF Cond µS/cm | ODO % sat | ODO % local | ODO mg/L | Pressure psi a | Sal psu | SpCond µS/cm | TAL PE RFU | TDS mg/L | Turbidity FNU | TSS mg/L | pH | pH mV | Temp °C | Vertical Position m | Battery V | Cable Pwr V | Chl (ug/L)
5/13/2024 | 11:28:26 | DI | 0 | Lab | 0.63 | 2.3 | 0.086 | 7.68 | 2.56 | 2.3 | 88.8 | 88.5 | 7.38 | 0.122 | 0 | 2.3 | 0.78 | 2 | -0.21 | 0 | 3.79 | 149.8 | 24.66 | 0.082 | 0 | 12 | 2.54079
5/13/2024 | 11:28:27 | DI | 0 | Lab | 0.63 | 2.3 | 0.086 | 7.68 | 2.56 | 2.3 | 88.8 | 88.5 | 7.38 | 0.122 | 0 | 2.3 | 0.78 | 2 | -0.21 | 0 | 3.79 | 149.8 | 24.66 | 0.082 | 0 | 12 | 2.54079
5/13/2024 | 11:28:28 | DI | 0 | Lab | 0.65 | 2.3 | 0.086 | 7.07 | 2.36 | 2.3 | 88.8 | 88.5 | 7.38 | 0.122 | 0 | 2.3 | 0.78 | 2 | -0.22 | 0 | 3.79 | 149.8 | 24.661 | 0.085 | 0 | 12 | 2.62145
5/13/2024 | 11:28:29 | DI | 0 | Lab | 0.66 | 2.3 | 0.085 | 6.68 | 2.23 | 2.3 | 88.8 | 88.5 | 7.38 | 0.121 | 0 | 2.3 | 0.78 | 2 | -0.21 | 0 | 3.79 | 149.8 | 24.661 | 0.083 | 0 | 12 | 2.66178
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
