COAST-Lab/Low-Cost-Multiparameter-Water-Quality-Sensor/Chlorophyll/Data Analysis/AS7341 Dilution Tests/AS7341 Dilutions 1.5.24/1_5_24_700ms_256x_LoD_graph.png

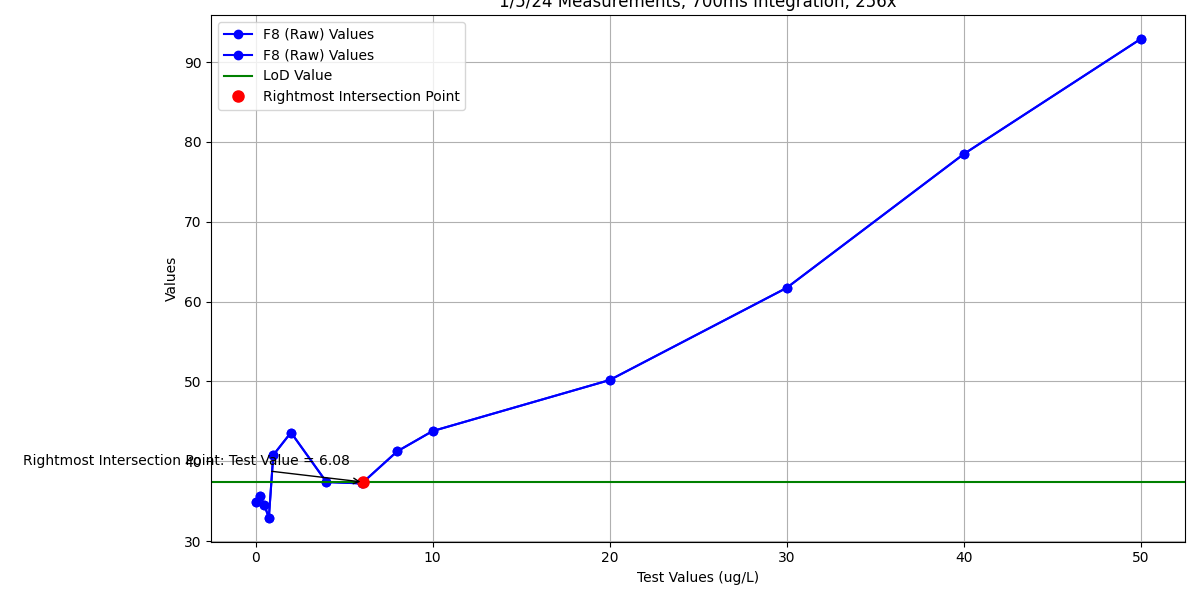
Chlorophyll/Data Analysis/AS7341 Dilution Tests/AS7341 Dilutions 1.5.24/1_5_24_700ms_256x_LoD_graph.png
