COAST-Lab/Low-Cost-Multiparameter-Water-Quality-Sensor/Chlorophyll/Data Analysis/AS7341 Dilution Tests/AS7341 Dilutions 12.15.23/12_15_23_700ms_256x_graph_LoD.png

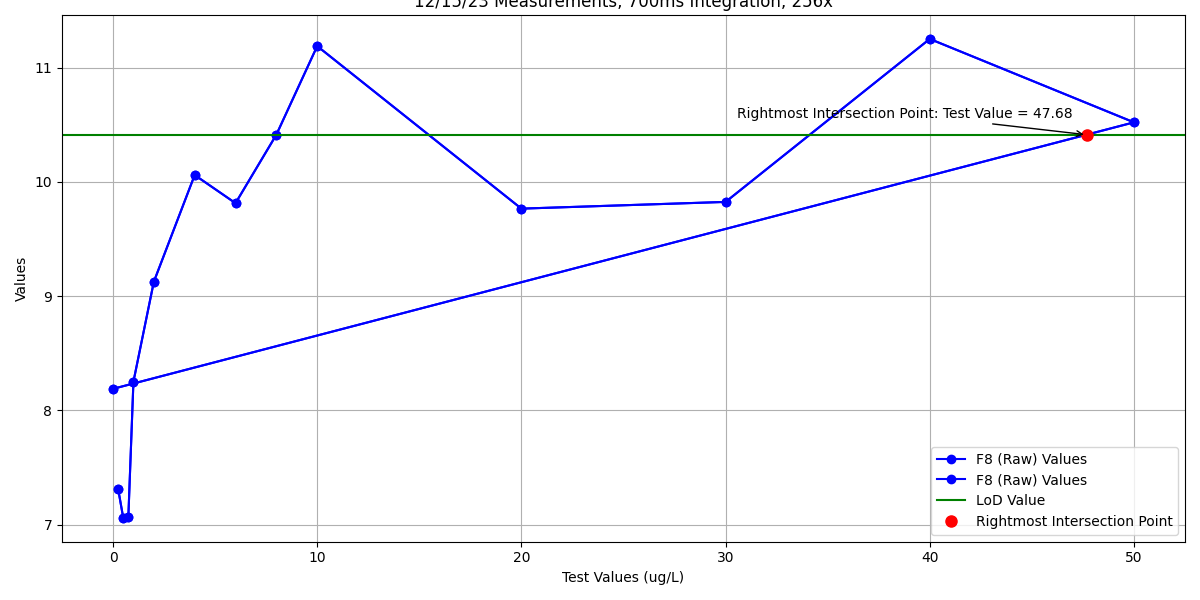
Chlorophyll/Data Analysis/AS7341 Dilution Tests/AS7341 Dilutions 12.15.23/12_15_23_700ms_256x_graph_LoD.png
