COAST-Lab/Low-Cost-Multiparameter-Water-Quality-Sensor/Chlorophyll/Data Analysis/AS7341 Dilution Tests/IO Rodeo Through Hole/2.12.24/2_12_24_700ms_128x_through_hole_dilutions_LOD.png

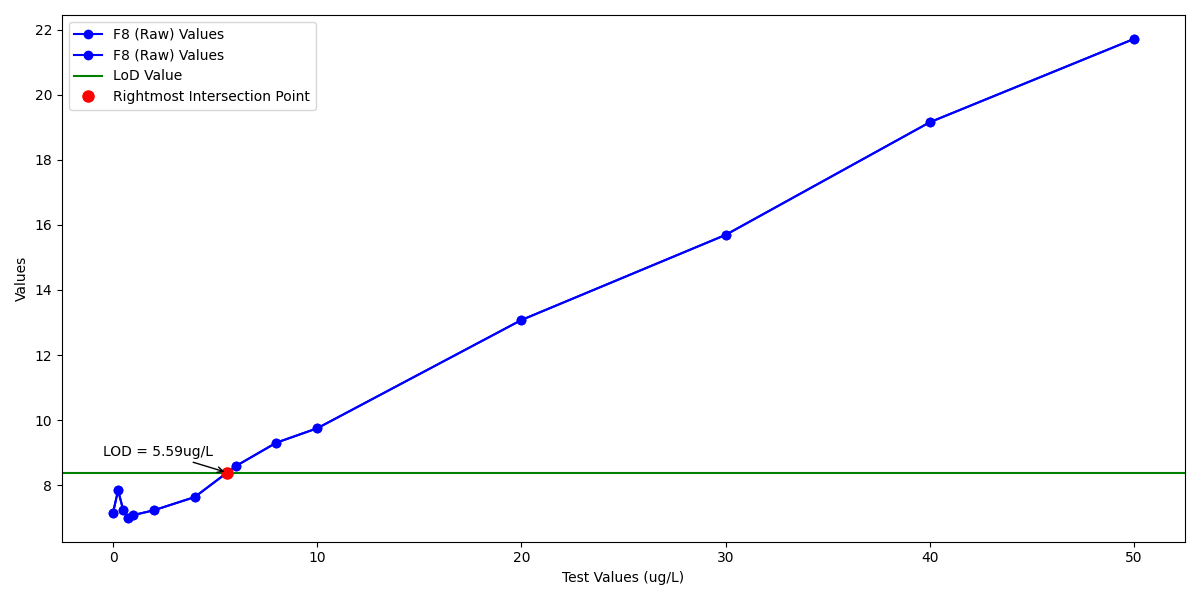
Chlorophyll/Data Analysis/AS7341 Dilution Tests/IO Rodeo Through Hole/2.12.24/2_12_24_700ms_128x_through_hole_dilutions_LOD.png
