COAST-Lab/Low-Cost-Multiparameter-Water-Quality-Sensor/Chlorophyll/Data Analysis/AS7341 Dilution Tests/IO Rodeo Through Hole/2.20.24/2_20_24_700ms_256x_through_hole_dilutions.png

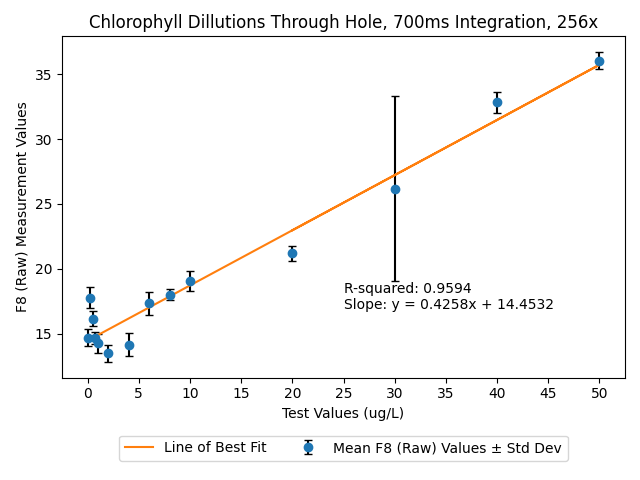
Chlorophyll/Data Analysis/AS7341 Dilution Tests/IO Rodeo Through Hole/2.20.24/2_20_24_700ms_256x_through_hole_dilutions.png
