COAST-Lab/Low-Cost-Multiparameter-Water-Quality-Sensor/Field Tests/4.15.24 Field Test/Chl_Cormp_vs_Sensor_4_15_outside_R2.png

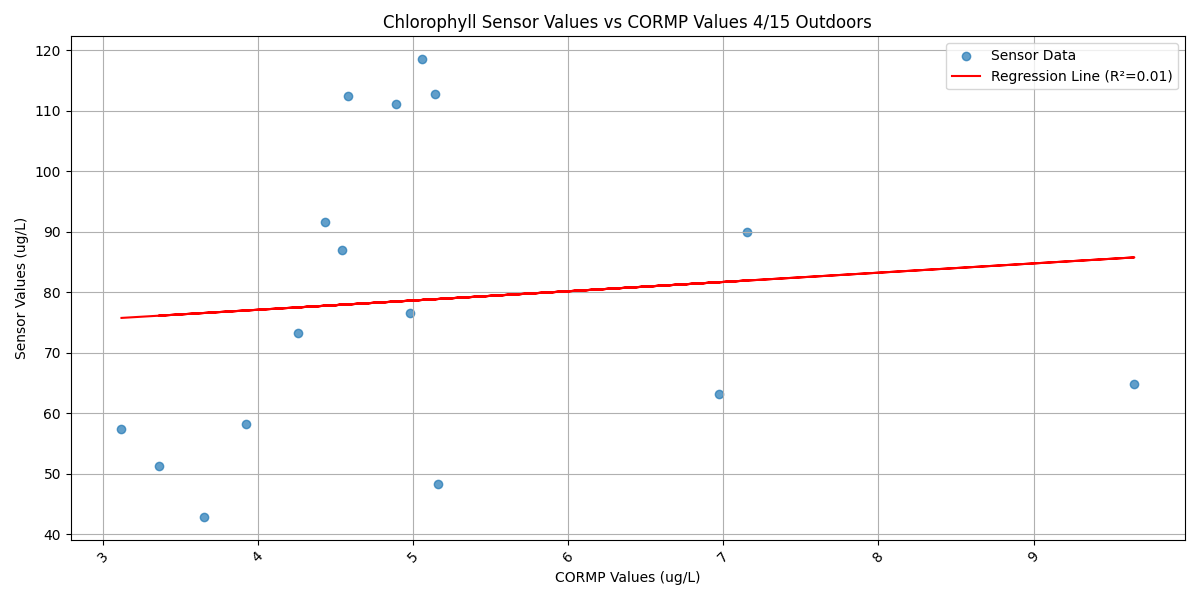
Field Tests/4.15.24 Field Test/Chl_Cormp_vs_Sensor_4_15_outside_R2.png
