COAST-Lab/Low-Cost-Multiparameter-Water-Quality-Sensor/Field Tests/4.15.24 Field Test/Turb_Sensor_CORMP_4_15_Outside_R2.png

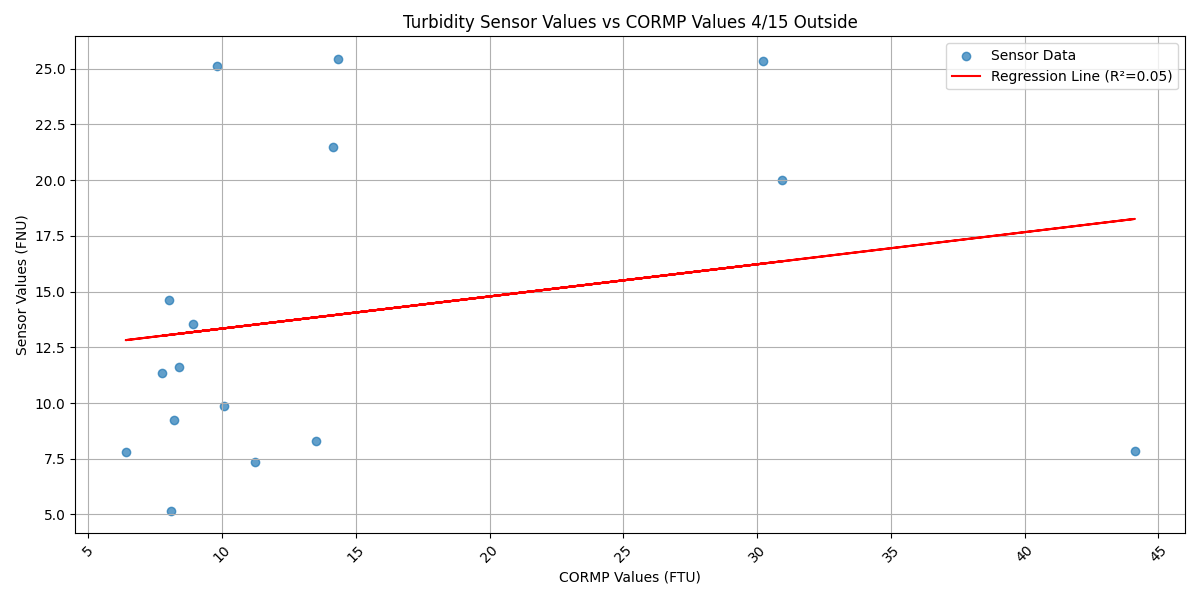
Field Tests/4.15.24 Field Test/Turb_Sensor_CORMP_4_15_Outside_R2.png
