COAST-Lab/Low-Cost-Multiparameter-Water-Quality-Sensor/Field Tests/4.23.24 Field Tests/Indoor Field Test/Chl_Cormp_vs_Sensor_4_23_Indoors_R2.png

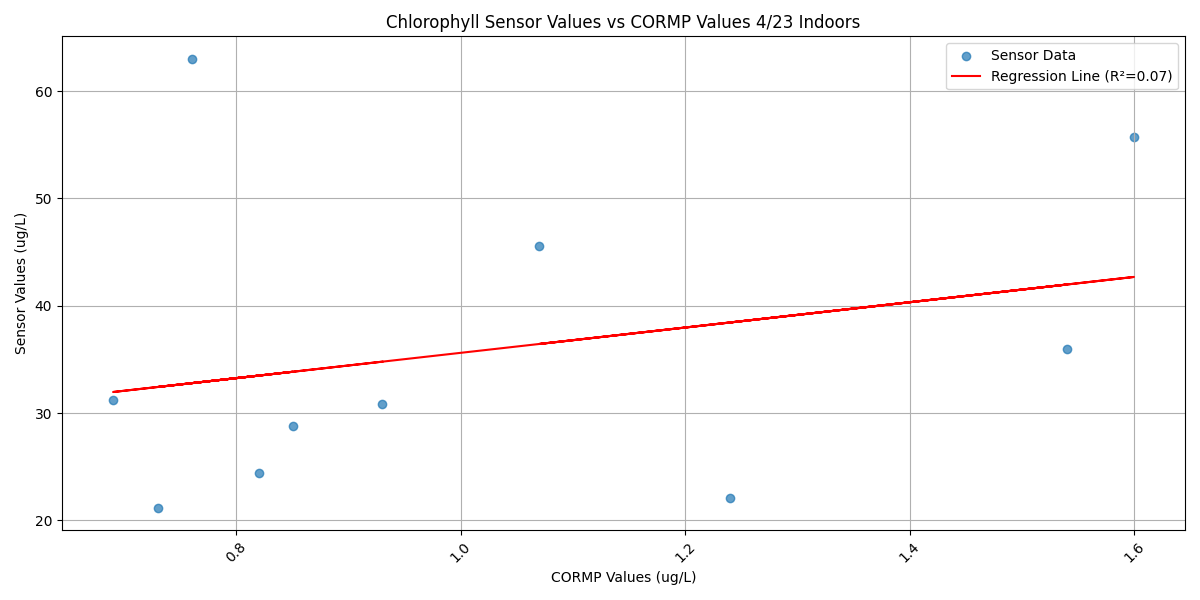
Field Tests/4.23.24 Field Tests/Indoor Field Test/Chl_Cormp_vs_Sensor_4_23_Indoors_R2.png
