COAST-Lab/Low-Cost-Multiparameter-Water-Quality-Sensor/Field Tests/4.23.24 Field Tests/Indoor Field Test/Turb_Sensor_CORMP_4_23_Inside_R2.png

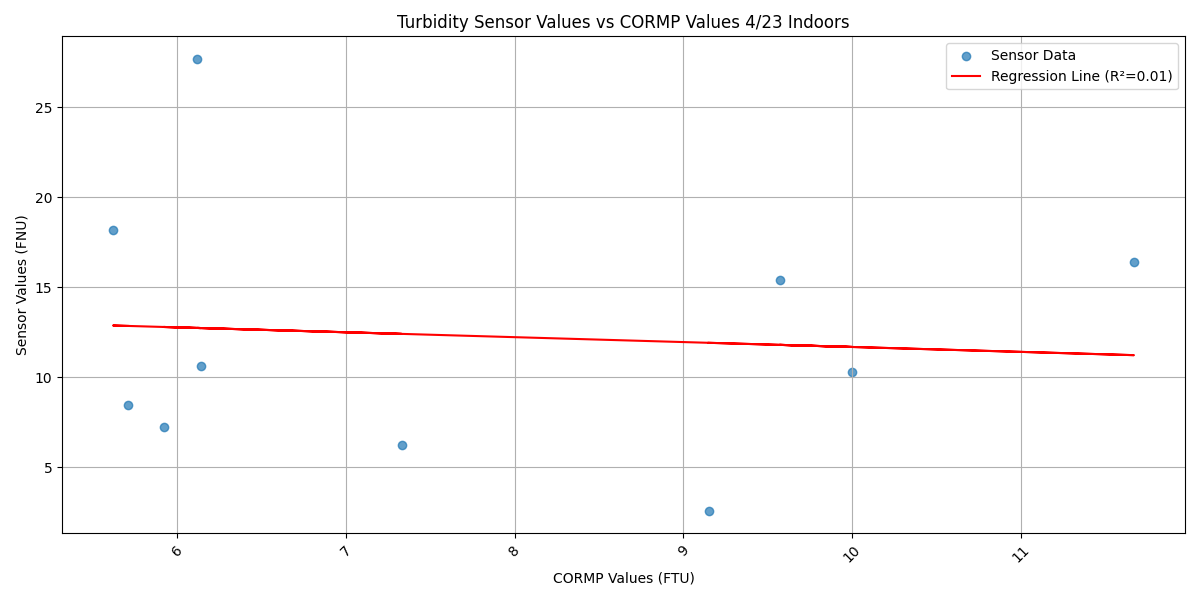
Field Tests/4.23.24 Field Tests/Indoor Field Test/Turb_Sensor_CORMP_4_23_Inside_R2.png
