COAST-Lab/Low-Cost-Multiparameter-Water-Quality-Sensor/Field Tests/4.23.24 Field Tests/Outdoor Field Test/Chl_Cormp_vs_Sensor_4_23_Outdoors_r2.png

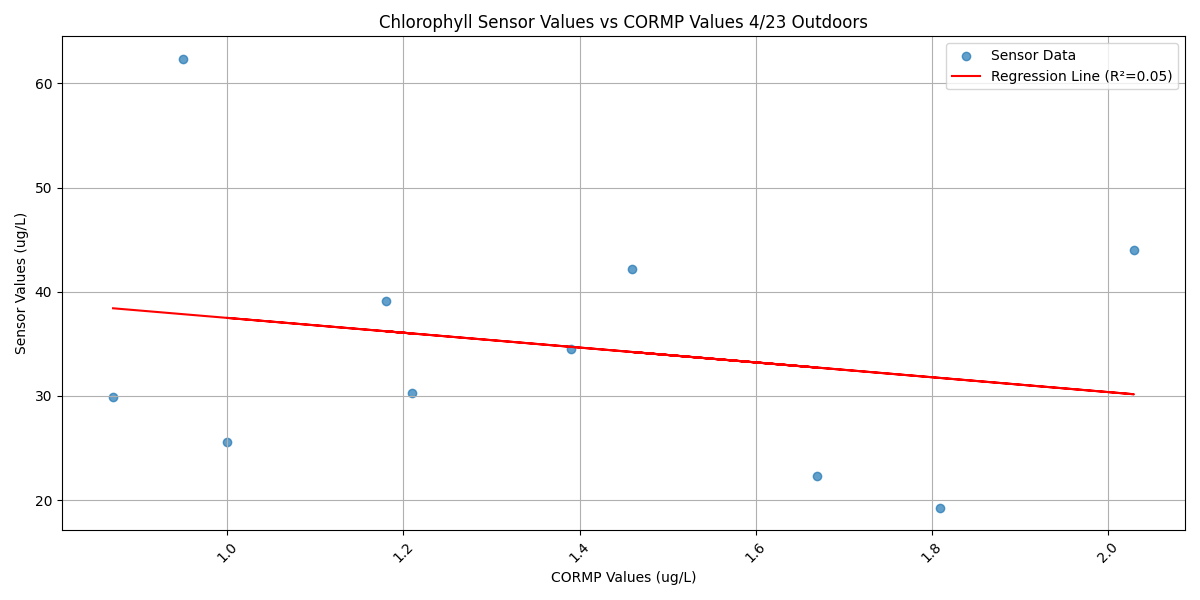
Field Tests/4.23.24 Field Tests/Outdoor Field Test/Chl_Cormp_vs_Sensor_4_23_Outdoors_r2.png
