COAST-Lab/Low-Cost-Multiparameter-Water-Quality-Sensor/Field Tests/In Lab Field Test/alan_vs_YSI.png

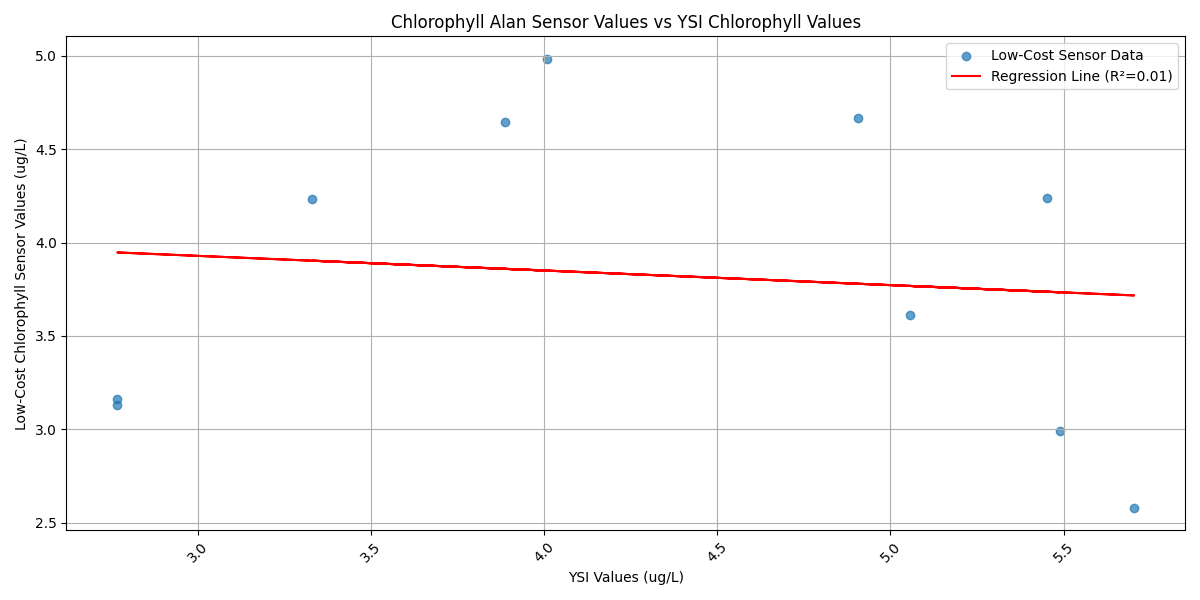
Field Tests/In Lab Field Test/alan_vs_YSI.png
