COAST-Lab/Low-Cost-Multiparameter-Water-Quality-Sensor/Field Tests/In Lab Field Test/chl_YSI_lab_lowcost.png

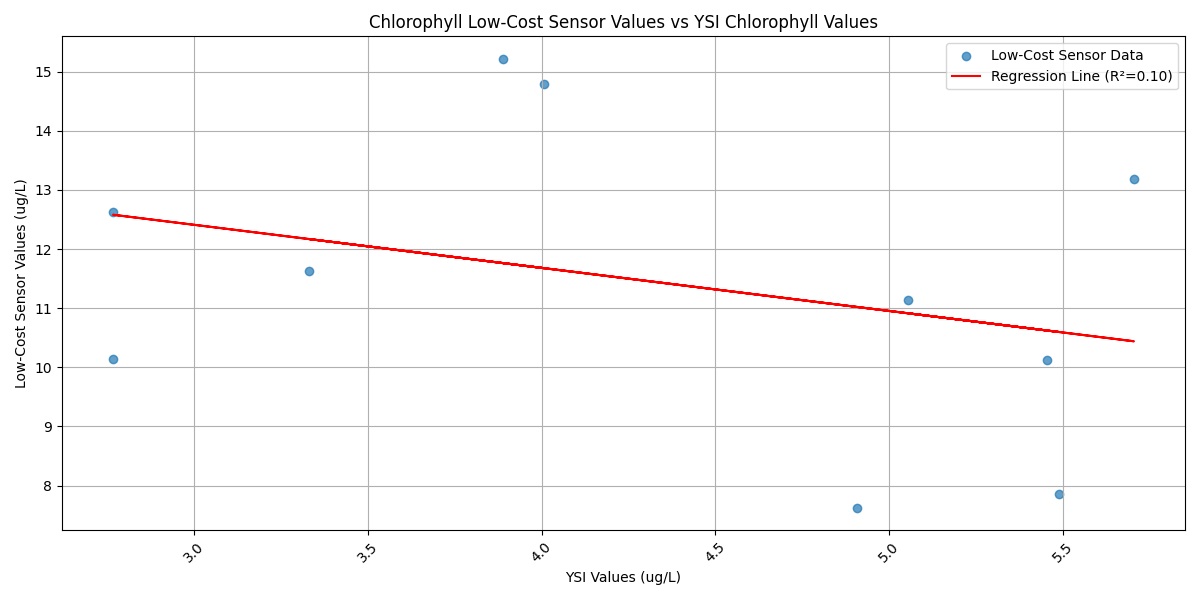
Field Tests/In Lab Field Test/chl_YSI_lab_lowcost.png
