COAST-Lab/Low-Cost-Multiparameter-Water-Quality-Sensor/Firmware/src/low_cost_multiparameter_sensor.ino

#include <Adafruit_AS7341.h>
#include <Adafruit_AW9523.h>
#include "RTClibrary.h"
#include <SdFat.h>

Adafruit_AS7341 as7341;
Adafruit_AW9523 aw;
RTC_PCF8523 rtc;
File myFile;

char daysOfTheWeek[7][12] = {"Sunday", "Monday", "Tuesday", "Wednesday", "Thursday", "Friday", "Saturday"};
const int SD_CHIP_SELECT = D5;

// Define an array of pin numbers for each LED
const uint8_t LedPins[] = {0, 1, 3, 10, 5}; // Define LedPin 10 as LedPins[0] and LedPin 0 as LedPins[1]

const int NumLEDs = sizeof(LedPins) / sizeof(LedPins[0]);

int LEDbright = 255;
int LEDdim = 0;

SdFat SD;

SYSTEM_THREAD(ENABLED);
SYSTEM_MODE(SEMI_AUTOMATIC);

void setup() {
  Serial.begin(9600);

  // Wait for communication with the host computer serial monitor
  while (!Serial) {
    delay(1);
  }

  if (!as7341.begin(0x39)){
    Serial.println("Could not find AS7341");
    while (1) { delay(10); }
  }

  as7341.setATIME(255);      
  as7341.setASTEP(999);
  as7341.setGain(AS7341_GAIN_128X);

  if (! rtc.begin()) {
    Serial.println("Couldn't find RTC");
    while (1);
  }

  if (! rtc.initialized()) {
    Serial.println("RTC is NOT running!");
  }

  if (! aw.begin(0x58)) {
    Serial.println("AW9523 not found? Check wiring!");
    while (1) delay(10);  // halt forever
  }

  Serial.println("AW9523 found!");

  for (int i = 0; i < NumLEDs; i++) {
    aw.pinMode(LedPins[i], AW9523_LED_MODE);
  }

  SD.begin(SD_CHIP_SELECT);

  File file = SD.open("Test_3.csv", FILE_WRITE);

  if (file) {
    file.println("Date and Time,ASTEP,ATIME,GAIN,LED Status,LED Intensity,Test,Seconds,Milliseconds,Type,F1 (Basic),F2 (Basic),F3 (Basic),F4 (Basic),F5 (Basic),F6 (Basic),F7 (Basic),F8 (Basic),Clear (Basic),NIR (Basic),Type,F1 (Raw),F2 (Raw),F3 (Raw),F4 (Raw),F5 (Raw),F6 (Raw),F7 (Raw),F8 (Raw),Clear (Raw),NIR (Raw),Measurement Type"); // Updated Headers
    file.close();
  } else {
    Serial.println(F("Error opening file!"));
  }
}

void loop() {
  // Blink LED 2 on/off twice
  blinkLED(2, 2);
  Serial.println("begin chlorophyll measurements");

  // Turn on LED 1 for one minute and print results
  turnOnLED(3, 60000, "chlorophyll a");

  // Blink LED 2 on/off once
  blinkLED(2, 2);
  Serial.println("End chlorophyll measurements");

  // Blink LED 2 on/off three times
  blinkLED(2, 3);
  Serial.println("Begin turbidity measurements");

  // Turn on LED 0 for one minute and print results
  turnOnLED(0, 60000, "turbidity");

  // Blink LED 2 on/off once
  blinkLED(2, 2);
  Serial.println("End turbidity measurements");

  // Turn on LED 3 forever
  aw.analogWrite(LedPins[3], LEDdim);
  aw.analogWrite(LedPins[2], LEDbright);

  while (1) {
    delay(1);
  }
}

void blinkLED(uint8_t ledIndex, int blinkCount) {
  for (int i = 0; i < blinkCount; i++) {
    aw.analogWrite(LedPins[ledIndex], LEDbright);
    delay(500);
    aw.analogWrite(LedPins[ledIndex], LEDdim);
    delay(500);
  }
}

void turnOnLED(uint8_t ledIndex, unsigned long duration, const char* measurementType) {
  unsigned long startTime = millis();
  while (millis() - startTime < duration) {
    for (int i = 0; i < NumLEDs; i++) {
      if (i == ledIndex) {
        aw.analogWrite(LedPins[i], LEDbright);
      } else {
        aw.analogWrite(LedPins[i], LEDdim);
      }
    }
    fileprintresults(SD, rtc, measurementType);
    serialprintresults(rtc, measurementType);
  }
}

void fileprintresults(SdFat &sd, RTC_PCF8523 &rtc, const char* measurementType) {
  File file = sd.open("Test_3.csv", FILE_WRITE);
  DateTime now = rtc.now();

  uint16_t readings[12];
  float counts[12];

  if (!as7341.readAllChannels(readings)){
    Serial.println("Error reading all channels!");
    return;
  }

  for(uint8_t i = 0; i < 12; i++) {
    if(i == 4 || i == 5) continue;
    counts[i] = as7341.toBasicCounts(readings[i]);
  }

  if (file) {
    file.print(now.year(), DEC);
    file.print('/');
    file.print(now.month(), DEC);
    file.print('/');
    file.print(now.day(), DEC);
    file.print(" (");
    file.print(daysOfTheWeek[now.dayOfTheWeek()]);
    file.print(") ");
    file.print(now.hour(), DEC);
    file.print(':');
    file.print(now.minute(), DEC);
    file.print(':');
    file.print(now.second(), DEC);
    file.print(',');
    file.print(as7341.getASTEP());
    file.print(',');
    file.print(as7341.getATIME());
    file.print(',');
    file.print(as7341.getGain());
    file.print(',');
    file.print("LED Status");
    file.print(',');
    file.print("LED Intensity");
    file.print(',');
    file.print("6.0");
    file.print(',');
    file.print(millis() / 1000);
    file.print(','); 
    file.print(millis());
    file.print(',');
    file.print("BASIC COUNTS");
    file.print(',');
    file.print(counts[0]);
    file.print(',');
    file.print(counts[1]);
    file.print(',');
    file.print(counts[2]);
    file.print(',');
    file.print(counts[3]);
    file.print(',');
    file.print(counts[6]);
    file.print(',');
    file.print(counts[7]);
    file.print(',');
    file.print(counts[8]);
    file.print(',');
    file.print(counts[9]);
    file.print(',');
    file.print(counts[10]);
    file.print(',');
    file.print(counts[11]);
    file.print(',');
    file.print("RAW VALUES");
    file.print(',');
    file.print(readings[0]);
    file.print(',');
    file.print(readings[1]);
    file.print(',');
    file.print(readings[2]);
    file.print(',');
    file.print(readings[3]);
    file.print(',');
    file.print(readings[6]);
    file.print(',');
    file.print(readings[7]);
    file.print(',');
    file.print(readings[8]);
    file.print(',');
    file.print(readings[9]);
    file.print(',');
    file.print(readings[10]);
    file.print(',');
    file.print(readings[11]);
    file.print(',');
    file.println(measurementType);  // Add measurement type

    file.close();
  }
  else {
    Serial.println(F("Error opening file!"));
  }
}

void serialprintresults(RTC_PCF8523 &rtc, const char* measurementType) {
  DateTime now = rtc.now();

  uint16_t readings[12];
  float counts[12];

  if (!as7341.readAllChannels(readings)){
    Serial.println("Error reading all channels!");
    return;
  }

  for(uint8_t i = 0; i < 12; i++) {
    if(i == 4 || i == 5) continue;
    counts[i] = as7341.toBasicCounts(readings[i]);
  }

  Serial.print(',');
  Serial.println(millis() / 1000);
  Serial.print("F1 415nm : ");
  Serial.print(counts[0]);
  Serial.print(" (");
  Serial.print(readings[0]);
  Serial.println(" raw)");

  Serial.print("F2 445nm : ");
  Serial.print(counts[1]);
  Serial.print(" (");
  Serial.print(readings[1]);
  Serial.println(" raw)");

  Serial.print("F3 480nm : ");
  Serial.print(counts[2]);
  Serial.print(" (");
  Serial.print(readings[2]);
  Serial.println(" raw)");

  Serial.print("F4 515nm : ");
  Serial.print(counts[3]);
  Serial.print(" (");
  Serial.print(readings[3]);
  Serial.println(" raw)");

  Serial.print("F5 555nm : ");
  Serial.print(counts[6]);
  Serial.print(" (");
  Serial.print(readings[6]);
  Serial.println(" raw)");

  Serial.print("F6 590nm : ");
  Serial.print(counts[7]);
  Serial.print(" (");
  Serial.print(readings[7]);
  Serial.println(" raw)");

  Serial.print("F7 630nm : ");
  Serial.print(counts[8]);
  Serial.print(" (");
  Serial.print(readings[8]);
  Serial.println(" raw)");

  Serial.print("F8 680nm : ");
  Serial.print(counts[9]);
  Serial.print(" (");
  Serial.print(readings[9]);
  Serial.println(" raw)");

  Serial.print("Clear    : ");
  Serial.print(counts[10]);
  Serial.print(" (");
  Serial.print(readings[10]);
  Serial.println(" raw)");

  Serial.print("NIR      : ");
  Serial.print(counts[11]);
  Serial.print(" (");
  Serial.print(readings[11]);
  Serial.println(" raw)");

  Serial.print("Measurement Type: ");
  Serial.println(measurementType);  // Add measurement type

  delay(1000);
}
